trant11/DMP-Ucebni-pomucky/DMP schéma.sch

## KiCad design DMP schéma.sch (2022-03-25)

Schematic: DMP schéma.sch

Parts:
D1, D2, D3: 1N4002; D_DO-41_SOD81_P10.16mm_Horizontal
K1, K2, K3: JZC-6F; Relay_1P1T_NO_10x24x18.8mm_Panasonic_ADW11xxxxW_THT
LED_I: LED
LED_V1: LED
LED_VR1, LED_VR2: LED
Q1, Q2, Q3: BC547; TO-92_Inline
R1, R2: R
R3, R4, R5, R6: R_Small
RGB1, RGB2, RGB3, RGB4, RGB5, RGB6, RGB7, RGB8, RGB9, RGB10: WS2812B; LED_WS2812B_PLCC4_5.0x5.0mm_P3.2mm
SW_I1: SW_MEC_5G
SW_V1: SW_MEC_5G
SW_VR1, SW_VR2: SW_MEC_5G
U1: STM8S003F3M; TSSOP-20_4.4x6.5mm_P0.65mm
V1: Voltmeter_DC
VR1, VR2: Voltmeter_DC
