trant11/DMP-Ucebni-pomucky/sources/inc/__assert__.h

#ifndef __ASSERT_H__
#define __ASSERT_H__ 1

// This is called by some of the SPL files on error.
#ifdef USE_FULL_ASSERT
/**
  * @brief  Reports the name of the source file and the source line number
  *   where the assert_param error has occurred.
  * @param file: pointer to the source file name
  * @param line: assert_param error line source number
  * @retval : None
  */
void assert_failed(uint8_t* file, uint32_t line)
{
  (void)file;
  (void)line;

  /* User can add their own implementation to report the file name and line number,
     ex: printf("Wrong parameters value: file %s on line %d\r\n", file, line) */

  /* Infinite loop */
  while (1)
  {
  }
}
#endif

#endif
